IIG2003/CNC_Plotter_ATMEGA328p/hardware/3d-parts/nema17-bracket/README.txt

NEMA 17 Stepper Motor Mount for V-Slot 2020 by PrintError on Thingiverse: https://www.thingiverse.com/thing:2449504

Summary:
Remix of Trigubovich's Nema 17 stepper motor mount.  Additions include V-slot support and minor chamfer and fillet changes.
