IIG2003/CNC_Plotter_ATMEGA328p/hardware/3d-parts/nema17-bracket/images/ac2e3ba1603fe23b4598f1adbbfc80b3.png

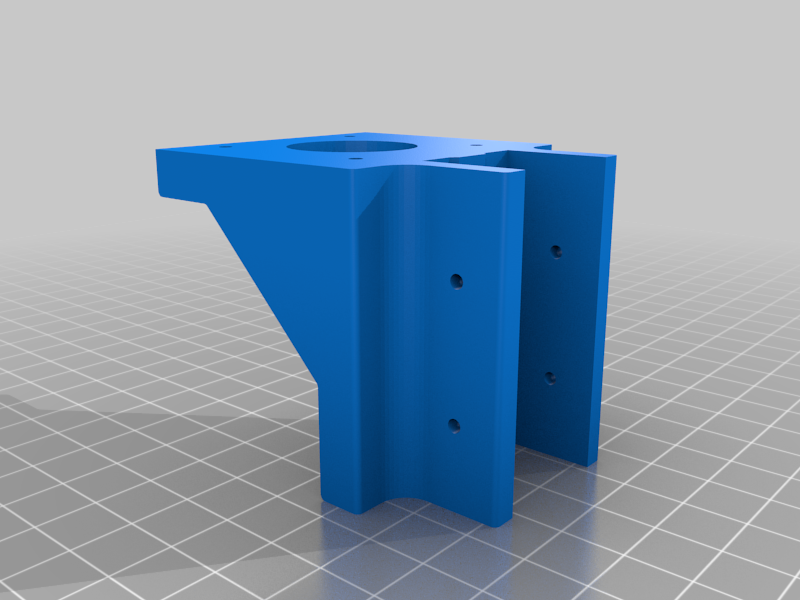
hardware/3d-parts/nema17-bracket/images/ac2e3ba1603fe23b4598f1adbbfc80b3.png
