IIG2003/CNC_Plotter_ATMEGA328p/hardware/3d-parts/nema17-bracket/images/cf86f97a2ceb6d07f9d9de6dec28d538.png

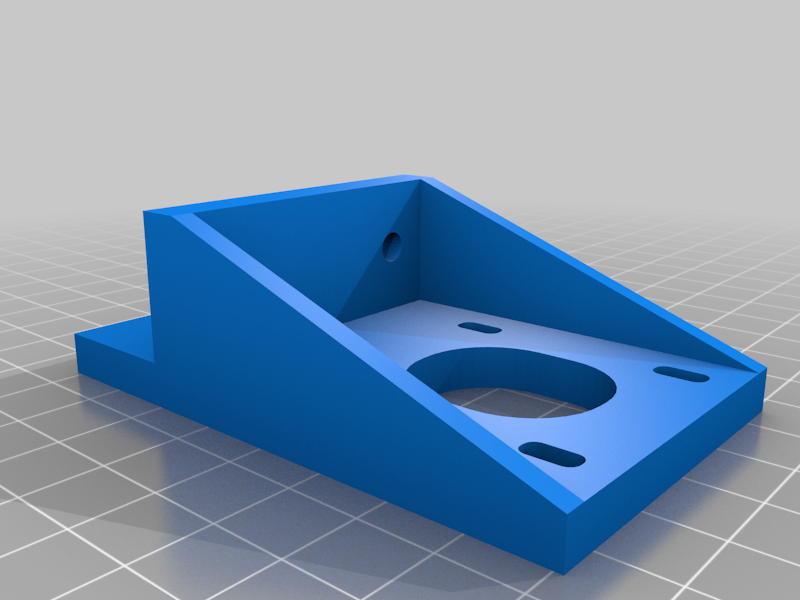
hardware/3d-parts/nema17-bracket/images/cf86f97a2ceb6d07f9d9de6dec28d538.png
