IIG2003/CNC_Plotter_ATMEGA328p/hardware/3d-parts/nema17-bracket/images/In_Solidworks.PNG

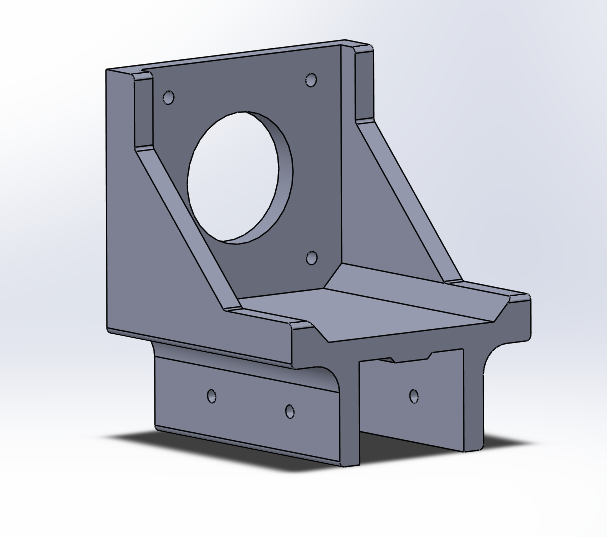
hardware/3d-parts/nema17-bracket/images/In_Solidworks.PNG
