IIG2003/CNC_Plotter_ATMEGA328p/hardware/3d-parts/baseend-idle.stl

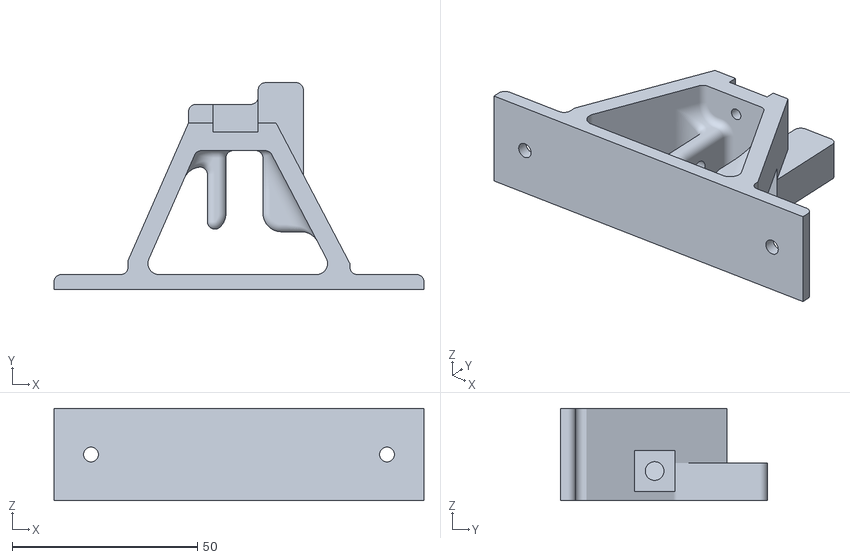
[picture p13: CAD file, 2026-10-20]
hardware/3d-parts/baseend-idle.stl
100.0 x 55.9 x 25.0
