IIG2003/CNC_Plotter_ATMEGA328p/hardware/3d-parts/nema17-bracket/files/NEMA17_Motor_Bracket_for_2020_or_2040.stl

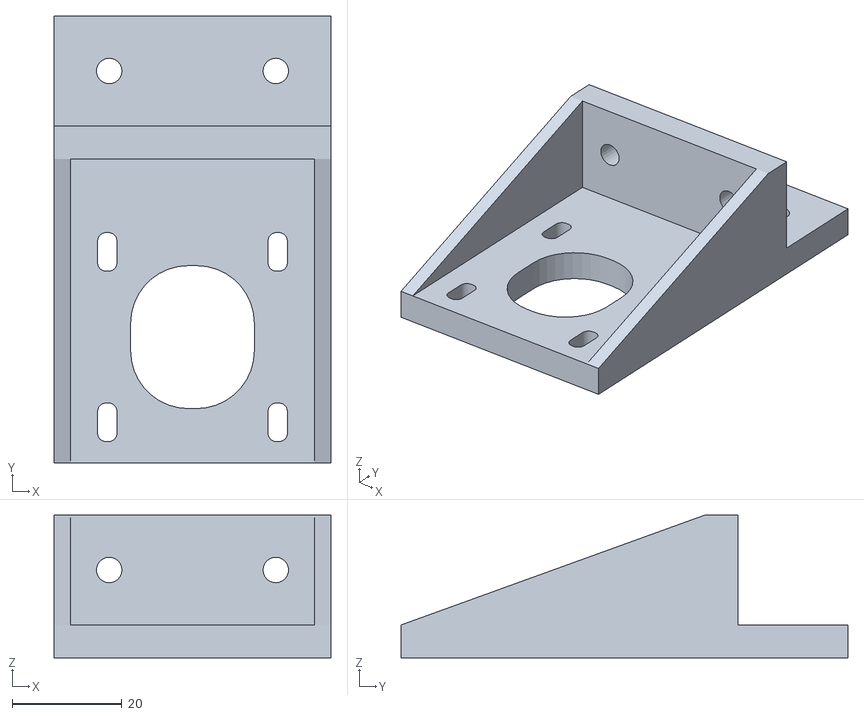
[picture p14: CAD file, 2026-10-20]
hardware/3d-parts/nema17-bracket/files/NEMA17_Motor_Bracket_for_2020_or_2040.stl
50.3 x 81.3 x 26.0
