IIG2003/CNC_Plotter_ATMEGA328p/hardware/3d-parts/carriage-4x.stl

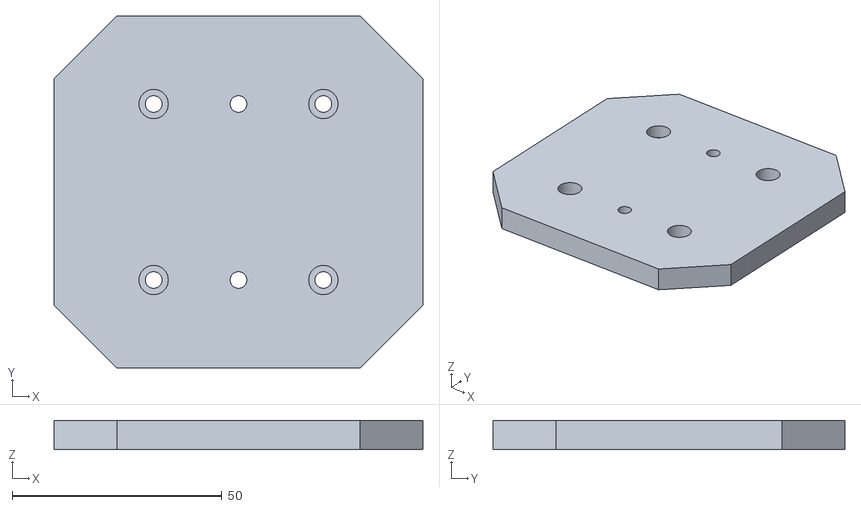
[picture p15: CAD file, 2026-10-20]
hardware/3d-parts/carriage-4x.stl
88.0 x 84.0 x 7.00
