IIG2003/CNC_Plotter_ATMEGA328p/hardware/3d-parts/nema17-bracket/files/NEMA_17_to_20201_-_V-Slot.SLDPRT

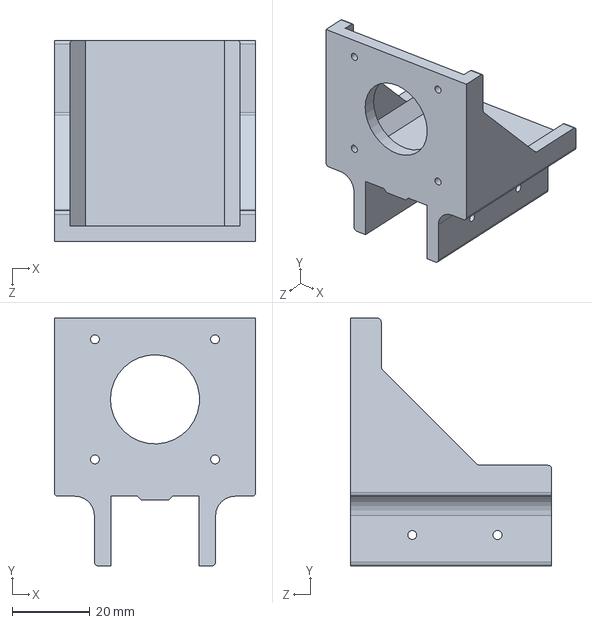
[picture p16: CAD file, 2026-10-20]
hardware/3d-parts/nema17-bracket/files/NEMA_17_to_20201_-_V-Slot.SLDPRT
52.0 x 64.0 x 52.0 mm
