IIG2003/CNC_Plotter_ATMEGA328p/hardware/3d-parts/nema_17_to_2020leftstl.stl

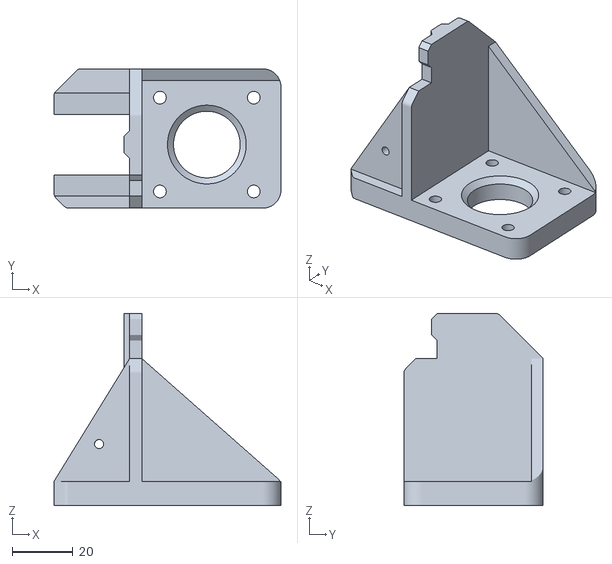
[picture p17: CAD file, 2026-10-20]
hardware/3d-parts/nema_17_to_2020leftstl.stl
75.0 x 46.0 x 63.5
