IIG2003/CNC_Plotter_ATMEGA328p/hardware/3d-parts/carriage-body.stl

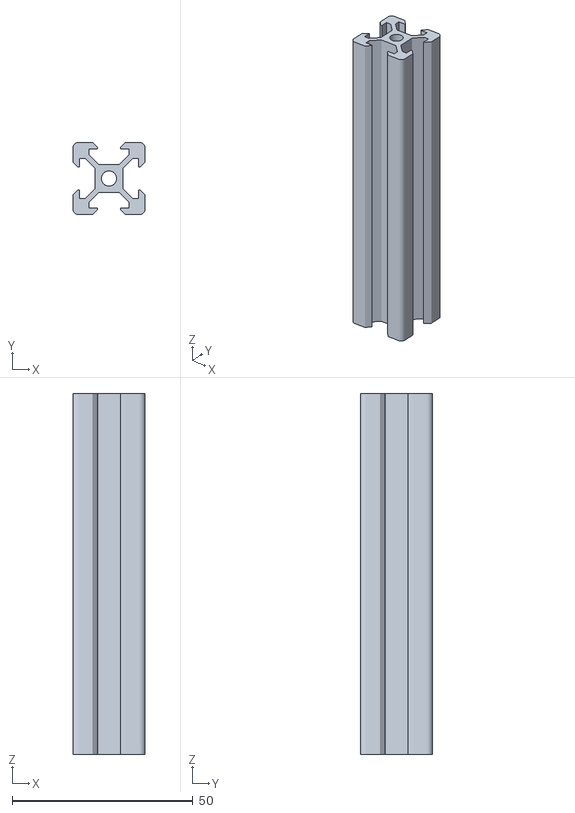
[picture p18: CAD file, 2026-10-20]
hardware/3d-parts/carriage-body.stl
20.0 x 20.0 x 100.0
