IIG2003/CNC_Plotter_ATMEGA328p/(list of files, cad)

Other CAD files:
hardware/3d-parts/nema17-bracket/files/NEMA_17_to_20201_-_V-Slot.STL
