IIG2003/CNC_Plotter_ATMEGA328p/docs/User_Guide.docx

XY G-Code Plotter

User Guide

A 2-axis pen plotter — how to set it up, mount the pen, and run a drawing

# 1. Overview

This machine is a 2-axis (X/Y) pen plotter. A controller board moves a pen holder over a fixed sheet of paper on an X/Y carriage, raising and lowering the pen with a small servo to draw lines from G-code. The G-code can be generated from a photo or line drawing, or written by hand.

Work area: 275 mm (X) × 190 mm (Y).

Drawings are prepared and sent from a PC using the included Plotter Studio app, which converts an image to a pen path, previews it, and streams it to the controller over USB.

# 2. Safety First

- Keep fingers, hair, and loose clothing clear of belts/leadscrews and the moving carriage while the machine is powered.
- Power off (unplug the motor supply and USB) before adjusting the pen holder, belts, or any wiring.
- Do not force the carriage by hand while powered — the motors resist movement and you can strip steps or damage a limit switch.
- Never leave the plotter running unattended for long unattended jobs; keep an eye on the first minute of every new drawing.

# 3. Components of the Machine

The plotter is built from the following parts:

Component | What it does
Frame / gantry | Rigid structure that keeps the X and Y rails square to each other and to the bed.
X-axis stepper motor | Drives the carriage left-right. Travel range: 275 mm.
Y-axis stepper motor | Drives the carriage forward-back. Travel range: 190 mm.
Stepper drivers (A4988 / DRV8825) | Sit on the controller board; turn step/direction signals from the controller into the current pulses that spin each motor.
Limit switches (X and Y) | Small mechanical switches at the home corner. The carriage taps each one on power-up so the controller always knows where (0,0) is.
Pen holder with servo | Clamps the pen and tilts it up or down. This is what lifts the pen clear for travel moves and lowers it to draw.
Pen | A standard marker, ballpoint, or fineliner that fits the holder's clamp.
Controller board (Arduino Uno) | Runs the G-code interpreter: reads commands from the PC, drives both steppers and the pen servo.
Motor power supply | A separate DC supply for the stepper motors — they draw more current than a USB port can provide.
USB cable | Connects the controller to the PC for sending G-code and for the homing/status messages.
Drawing bed | The flat surface the paper is taped to; matches the 275 × 190 mm work area.
Plotter Studio (PC app) | plotter_studio.py — loads an image or a .gcode file, previews the pen path, and streams it to the controller.

# 4. Mounting and Tensioning the Pen

Do this before every job, and re-check it whenever you swap to a pen of a different thickness. The holder has two holes the pen passes through on its way to the clamp: an outer (second) hole near the top, and the middle hole that centers and grips the barrel.

1. Power off or make sure the plotter is idle before touching the pen holder.

2. Loosen the holder's set screw fully so the clamp opens and the pen can slide freely.

3. Insert the pen from the top: feed it down through the outer (second) hole first, then guide the tip on through the middle hole so the barrel passes straight through both, centered and not at an angle.

4. With the holder in the “pen up” position, let the tip hang just below the bottom of the holder — far enough that it will reach the paper once lowered, but not so far that it jams against the bed.

5. Holding the pen at that depth, tighten the set screw against the barrel until it is snug — firm enough that the pen cannot slide or rotate in use, but not so tight that it cracks the barrel or strips the holder.

6. Check the tension: lower the holder to the “pen down” position over a scrap sheet. The tip should flex slightly and make solid, even contact with the paper — not skip, and not press so hard that it strains the servo or dents/tears the sheet.

7. Draw a short test line. If it is faint or broken, loosen the screw, lower the pen very slightly, and re-tighten. If the paper wrinkles or the servo strains, raise it very slightly and re-tighten.

Getting this tension right is the single biggest factor in line quality — it is worth a couple of test lines before starting a real drawing.

# 5. Loading Paper

- Tape or clip a sheet flat to the bed, aligned within the 275 × 190 mm work area, starting from the home corner (where the limit switches sit).
- Make sure the sheet lies completely flat — a bump or curl partway across the page will change the pen tension you just set for the rest of the drawing.

# 6. Powering On and Homing

- Connect the motor power supply first, then plug in the USB cable to the PC.
- On boot, the controller automatically drives the X axis, then the Y axis, toward their limit switches, backs off, and re-approaches slowly — this sets that corner as (0, 0).
- You will see “Homing…” followed by “Ready” over the serial connection when this finishes.
- Keep hands, tools, and the paper you are about to tape down clear of the bed while homing runs — the carriage moves on its own.

# 7. Running a Drawing with Plotter Studio

1. On the PC, start the app: python plotter_studio.py

2. Click Load Image… to use a photo or line drawing, or Load .gcode file… if you already have a prepared file.

3. For images, choose Edges (photos) or Threshold (line art) under Image processing, and adjust the sliders if the preview looks too sparse or too noisy.

4. Set the Margin so the drawing sits inside the bed with a border.

5. Check the Orientation options (Flip X, Flip Y, Rotate 90°) against the preview canvas so the path matches how you taped the paper down.

6. Set the Draw feed (mm/min) — slower feeds draw cleaner lines but take longer.

7. Click Generate Preview and confirm the traced path in the canvas looks right before sending anything.

8. Under Send via TTL Serial, choose the correct COM port and baud rate (9600 by default, unless the firmware was changed), then click Send to Plotter.

9. Confirm the bed is clear when prompted, and watch the first few lines run. Use Stop if anything looks wrong.

# 8. Troubleshooting

Symptom | What to do
Lines are faint or skip | The pen isn't seated deep enough. Loosen the set screw, lower the pen slightly, and re-tighten (see Section 4).
Paper tears, wrinkles, or the servo strains | The pen is set too deep. Raise it a touch and re-tighten.
Nothing happens after power-on | Check the USB cable, and make sure the baud rate selected in Plotter Studio matches the firmware (9600 by default).
Drawing comes out mirrored or upside-down | Toggle Flip X / Flip Y / Rotate 90° in the Orientation panel and click Generate Preview again.
Streaming stalls with “No response for line…” | Check the USB connection is still seated; click Stop and re-send.
