IIG2003/CNC_Plotter_ATMEGA328p/hardware/pcb/pcb-layout.pdf

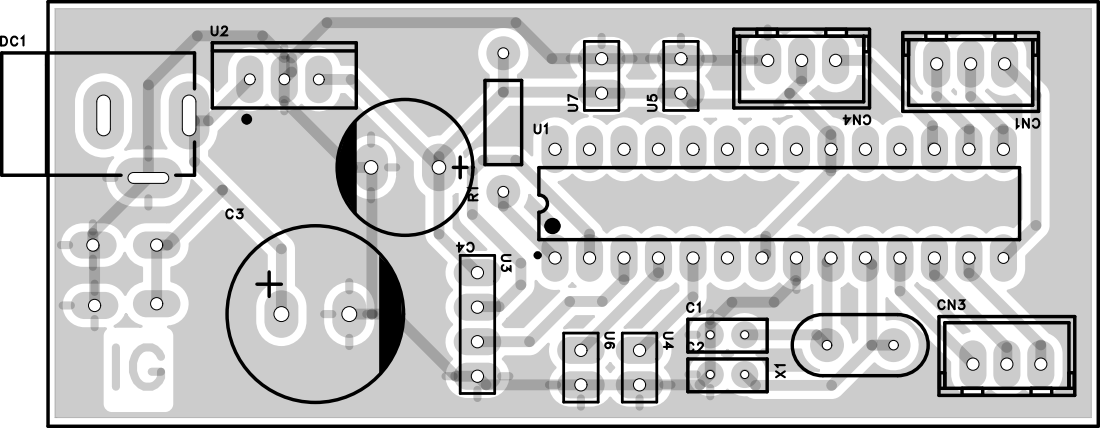
[picture p21: page 1]
