IIG2003/CNC_Plotter_ATMEGA328p/hardware/pcb/schematic.pdf

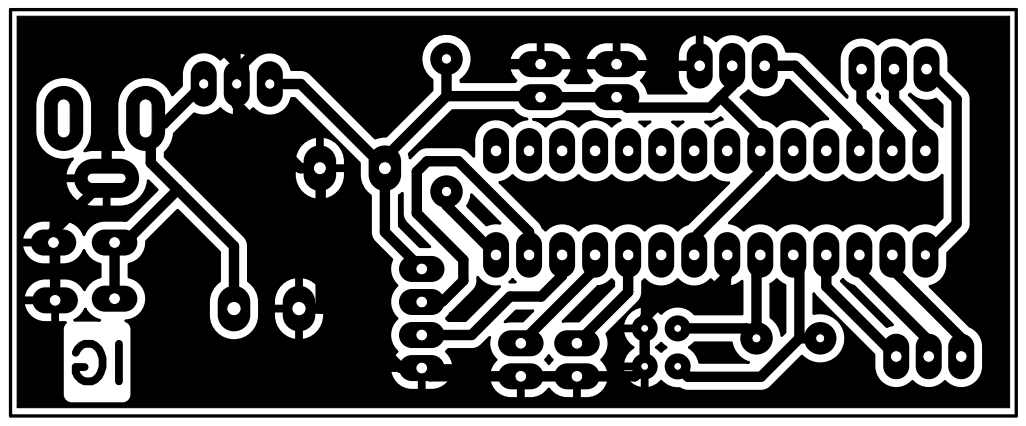
[picture p22: page 1]
