IIG2003/CNC_Plotter_ATMEGA328p/(list of files, drawings)

Other design files:
hardware/pcb/easyeda/cnc_machine.eprj
